rivertechlabs/babyturbidity/Calibration/Sensebox_calibration.xlsx

adc0 | NTU
540 | 970
602 | 750
656 | 530
687 | 410
729 | 283
750 | 192
770 | 134
775 | 90
790 | 50
806 | 20
 | 0
 |  | y=mx+b
 |  | y=mx^2+bx+c
