rivertechlabs/babyturbidity/Results/sihl_limmat_results.PNG

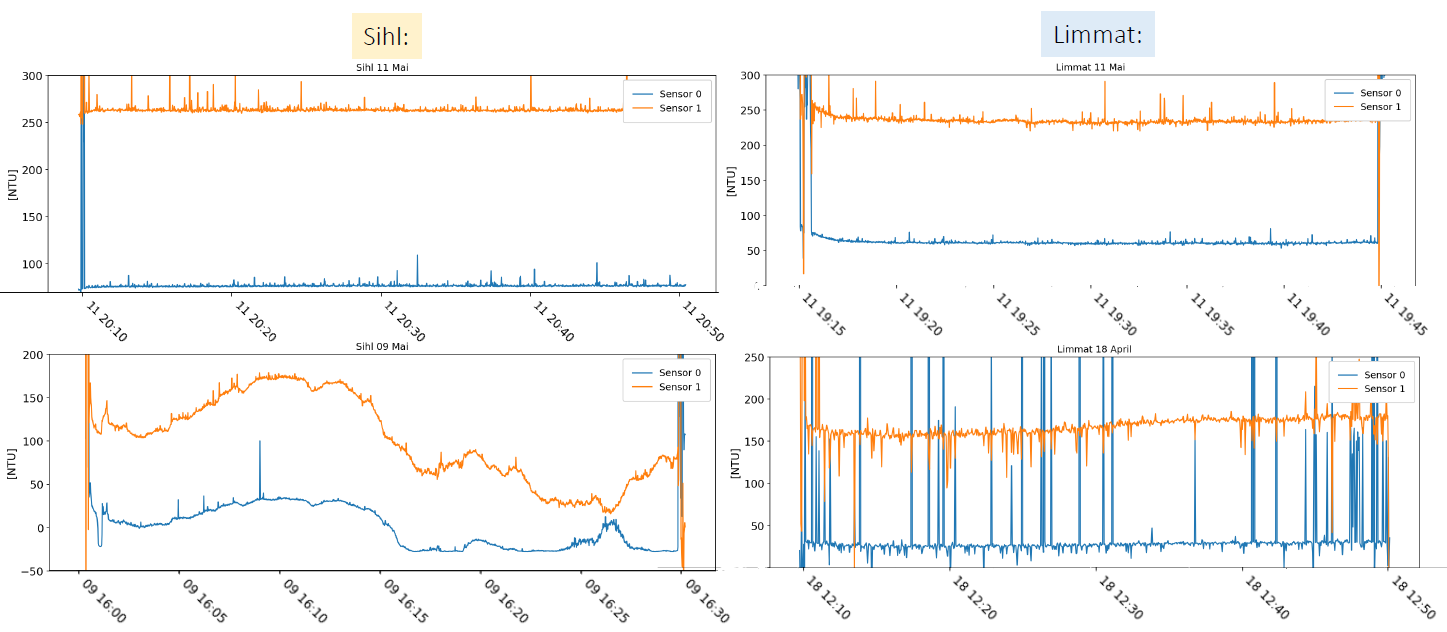
Results/sihl_limmat_results.PNG
