rivertechlabs/babyturbidity/(threads)

Thread 2 (2022-02-25):

Fix Arduino codes

StEvUgnIn, 2022-02-25:
I spotted a couple of problems that could be fixed in the `Codes` directory

Closed 2023-01-31.
